ese5160/a14g-final-submission-s25-t22-x-y-circuiteers/firmware_code/Application/src/DisplayTask/ST7735.h

/**
 * @file    ST7735.h
 * @brief   ST7735 TFT LCD definitions and drawing interface.
 *
 * Contains ASCII character bitmaps, ST7735 command macros, pin configuration,
 * screen dimensions, color definitions, and function declarations for LCD control.
 * Supports drawing pixels, characters, strings, rectangles, and sending SPI data.
 */


#include <asf.h>

#ifndef TFT_H_
#define TFT_H_
static const char ASCII[96][5] = {
	{0x00, 0x00, 0x00, 0x00, 0x00} // 20  (space)
	,{0x00, 0x00, 0x5f, 0x00, 0x00} // 21 !
	,{0x00, 0x07, 0x00, 0x07, 0x00} // 22 "
	,{0x14, 0x7f, 0x14, 0x7f, 0x14} // 23 #
	,{0x24, 0x2a, 0x7f, 0x2a, 0x12} // 24 $
	,{0x23, 0x13, 0x08, 0x64, 0x62} // 25 %
	,{0x36, 0x49, 0x55, 0x22, 0x50} // 26 &
	,{0x00, 0x05, 0x03, 0x00, 0x00} // 27 '
	,{0x00, 0x1c, 0x22, 0x41, 0x00} // 28 (
	,{0x00, 0x41, 0x22, 0x1c, 0x00} // 29 )
	,{0x14, 0x08, 0x3e, 0x08, 0x14} // 2a *
	,{0x08, 0x08, 0x3e, 0x08, 0x08} // 2b +
	,{0x00, 0x50, 0x30, 0x00, 0x00} // 2c ,
	,{0x08, 0x08, 0x08, 0x08, 0x08} // 2d -
	,{0x00, 0x60, 0x60, 0x00, 0x00} // 2e .
	,{0x20, 0x10, 0x08, 0x04, 0x02} // 2f /
	,{0x3e, 0x51, 0x49, 0x45, 0x3e} // 30 0
	,{0x00, 0x42, 0x7f, 0x40, 0x00} // 31 1
	,{0x42, 0x61, 0x51, 0x49, 0x46} // 32 2
	,{0x21, 0x41, 0x45, 0x4b, 0x31} // 33 3
	,{0x18, 0x14, 0x12, 0x7f, 0x10} // 34 4
	,{0x27, 0x45, 0x45, 0x45, 0x39} // 35 5
	,{0x3c, 0x4a, 0x49, 0x49, 0x30} // 36 6
	,{0x01, 0x71, 0x09, 0x05, 0x03} // 37 7
	,{0x36, 0x49, 0x49, 0x49, 0x36} // 38 8
	,{0x06, 0x49, 0x49, 0x29, 0x1e} // 39 9
	,{0x00, 0x36, 0x36, 0x00, 0x00} // 3a :
	,{0x00, 0x56, 0x36, 0x00, 0x00} // 3b ;
	,{0x08, 0x14, 0x22, 0x41, 0x00} // 3c <
	,{0x14, 0x14, 0x14, 0x14, 0x14} // 3d =
	,{0x00, 0x41, 0x22, 0x14, 0x08} // 3e >
	,{0x02, 0x01, 0x51, 0x09, 0x06} // 3f ?
	,{0x32, 0x49, 0x79, 0x41, 0x3e} // 40 @
	,{0x7e, 0x11, 0x11, 0x11, 0x7e} // 41 A
	,{0x7f, 0x49, 0x49, 0x49, 0x36} // 42 B
	,{0x3e, 0x41, 0x41, 0x41, 0x22} // 43 C
	,{0x7f, 0x41, 0x41, 0x22, 0x1c} // 44 D
	,{0x7f, 0x49, 0x49, 0x49, 0x41} // 45 E
	,{0x7f, 0x09, 0x09, 0x09, 0x01} // 46 F
	,{0x3e, 0x41, 0x49, 0x49, 0x7a} // 47 G
	,{0x7f, 0x08, 0x08, 0x08, 0x7f} // 48 H
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
}; // end char ASCII[96][5]

// ST7735 registers
#define ST7735_NOP     0x00
#define ST7735_SWRESET 0x01
#define ST7735_RDDID   0x04
#define ST7735_RDDST   0x09
#define ST7735_SLPIN   0x10
#define ST7735_SLPOUT  0x11
#define ST7735_PTLON   0x12
#define ST7735_NORON   0x13
#define ST7735_INVOFF  0x20
#define ST7735_INVON   0x21
#define ST7735_DISPOFF 0x28
#define ST7735_DISPON  0x29
#define ST7735_CASET   0x2A
#define ST7735_RASET   0x2B
#define ST7735_RAMWR   0x2C
#define ST7735_RAMRD   0x2E
#define ST7735_PTLAR   0x30
#define ST7735_COLMOD  0x3A
#define ST7735_MADCTL  0x36
#define ST7735_FRMCTR1 0xB1
#define ST7735_FRMCTR2 0xB2
#define ST7735_FRMCTR3 0xB3
#define ST7735_INVCTR  0xB4
#define ST7735_DISSET5 0xB6
#define ST7735_PWCTR1  0xC0
#define ST7735_PWCTR2  0xC1
#define ST7735_PWCTR3  0xC2
#define ST7735_PWCTR4  0xC3
#define ST7735_PWCTR5  0xC4
#define ST7735_VMCTR1  0xC5
#define ST7735_RDID1   0xDA
#define ST7735_RDID2   0xDB
#define ST7735_RDID3   0xDC
#define ST7735_RDID4   0xDD
#define ST7735_PWCTR6  0xFC
#define ST7735_GMCTRP1 0xE0
#define ST7735_GMCTRN1 0xE1

#define MADCTL_MY  0x80
#define MADCTL_MX  0x40
#define MADCTL_MV  0x20
#define MADCTL_ML  0x10
#define MADCTL_RGB 0x00
#define MADCTL_BGR 0x08
#define MADCTL_MH  0x04

#define _GRAMWIDTH 128
#define _GRAMHEIGH 160 
#define _GRAMSIZE  _GRAMWIDTH * _GRAMHEIGH

// colors
#define	BLACK     0x0000
#define WHITE     0xFFFF
#define	BLUE      0x001F
#define	RED       0xF800
#define	GREEN     0x07E0
#define CYAN      0x07FF
#define MAGENTA   0xF81F
#define YELLOW    0xFFE0
#define MYCOLOR   0x901f


#define DAT_PIN PIN_PA21
#define SLAVE_SELECT_PIN PIN_PA22
#define CONF_MASTER_MUX_SETTING SPI_SIGNAL_MUX_SETTING_E
#define CONF_MASTER_PINMUX_PAD0 PINMUX_UNUSED
#define CONF_MASTER_PINMUX_PAD1 PINMUX_UNUSED
#define CONF_MASTER_PINMUX_PAD2 PINMUX_PA24D_SERCOM5_PAD2
#define CONF_MASTER_PINMUX_PAD3 PINMUX_PA25D_SERCOM5_PAD3
#define CONF_MASTER_SPI_MODULE SERCOM5

#define ST77XX_MADCTL_MY  0x80
#define ST77XX_MADCTL_MX  0x40
#define ST77XX_MADCTL_MV  0x20
#define ST77XX_MADCTL_ML  0x10
#define ST77XX_MADCTL_RGB 0x00
#define ST77XX_MADCTL  0x36

#define MAX_X 160
#define MAX_Y 128

void spi_io(unsigned char); // send and rx a byte over spi
void configure_port_pins_LCD(void);
void configure_spi_master(void);

void drawChar(short x, short y, unsigned char c, short fg, short bg);
void drawString(short x, short y, char* str, short fg, short bg);
void drawRectangle(short x1, short y1, short x2, short y2, short c);

void LCD_command(unsigned char); // send a command to the LCD
void LCD_data(unsigned char); // send data to the LCD
void LCD_data16(unsigned short); // send 16 bit data to the LCD
void LCD_init(void); // send the initializations to the LCD
void LCD_drawPixel(unsigned short, unsigned short, unsigned short); // set the x,y pixel to a color
void LCD_setAddr(unsigned short, unsigned short, unsigned short, unsigned short); // set the memory address you are writing to
void LCD_clearScreen(unsigned short); // set the color of every pixel

#endif /* TFT_H_ */
