ese5160/a14g-final-submission-s25-t22-x-y-circuiteers/firmware_code/Application/src/DisplayTask/DisplayTask.h

/**
 * @file    DisplayTask.h
 * @brief   Declaration for the FreeRTOS LCD display task.
 *
 * Provides the interface for displaying sensor data and system state on the ST7735 screen.
 */

#ifndef DISPLAYTASK_H_
#define DISPLAYTASK_H_

void vDisplayTask(void *pvParameters);

#endif /* DISPLAYTASK_H_ */
