ese5160/a14g-final-submission-s25-t22-x-y-circuiteers/firmware_code/Application/src/EnvTask/US100.h

#ifndef US100_H_
#define US100_H_

#include <stdint.h>

#define TRIG_PIN  PIN_PA06
#define ECHO_PIN  PIN_PA05
#define TIMER_TC  TC4

void Ultrasonic_Init(void);
void Ultrasonic_Trigger(void);
int32_t Ultrasonic_GetDistanceCM(void);

#endif
